zerberros/Audio_interfaces/README.md

# Audio_interfaces
Collection of audio interfaces

## CM6631 audio USB interface 

* USB2.0 true high-speed audio processor.

## CC85XX wireless interface

* (planned)
