zerberros/Audio_interfaces/USB_interface_board_CM6631/documentation/USB_Comunication-USB_Comunication.pdf

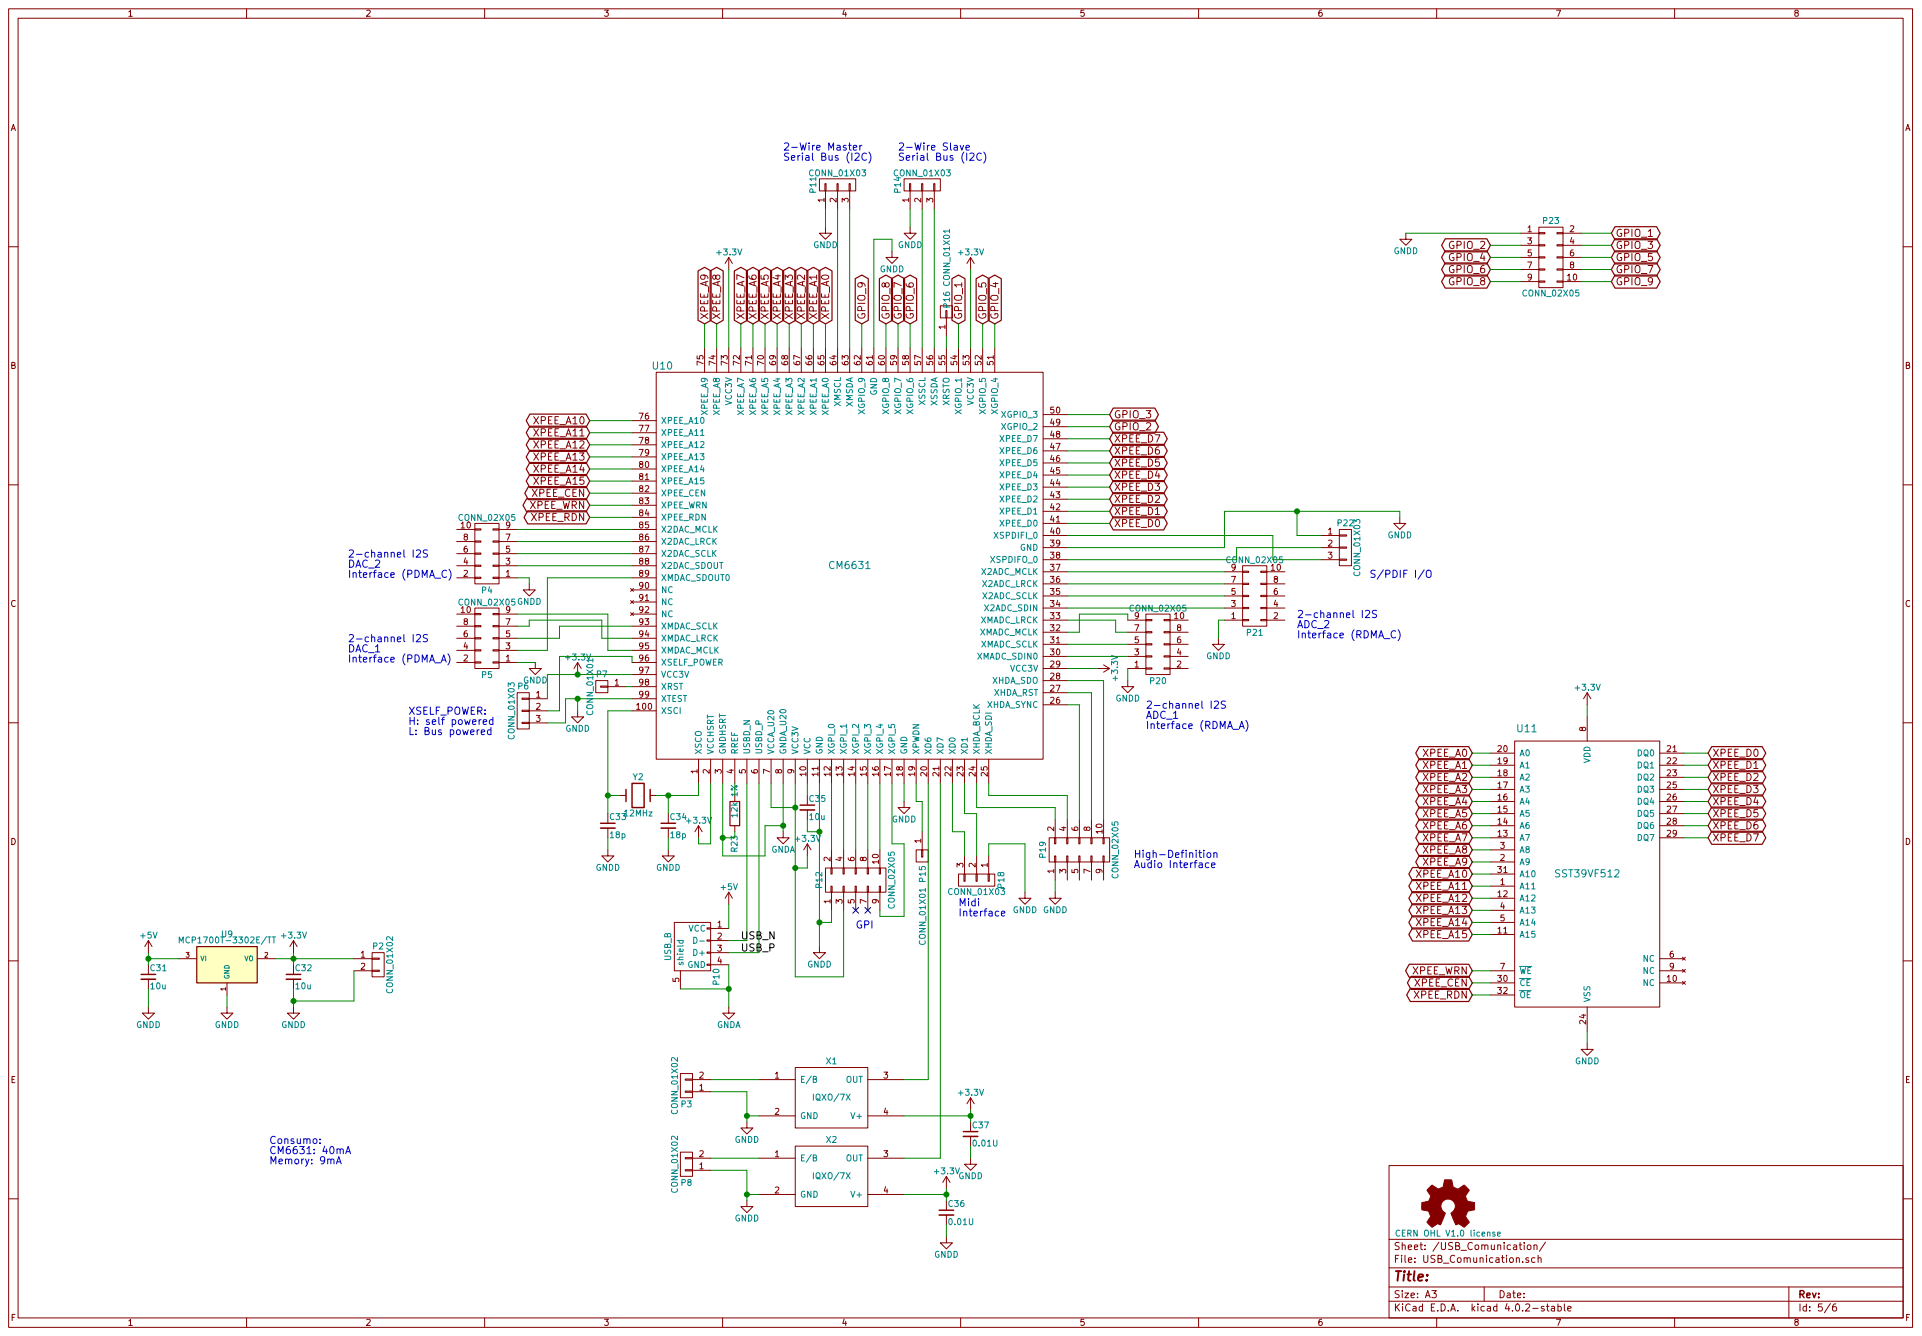
[picture p7: page 1]

1 P15 CONN_01X01 2-Wire Master Serial Bus (I2C)

9 VCC 10 XD6 20 XMADC_SDIN0 30 XSPDIFI_0 40 XGPIO_3 XGPIO_8 50 60 XPEE_A5 70 XPEE_A14 80 NC 90 GND 11 XD7 21 XMADC_SCLK 31 XPEE_D0 41 XGPIO_4 51 GND 61 XPEE_A6 71 XPEE_A15 81 NC 91 XGPI_0 12 XD0 22 XMADC_MCLK 32 XPEE_D1 42 XGPIO_5 52 XGPIO_9 62 XPEE_A7 72 XPEE_CEN 82 NC 92 XGPI_1 13 XD1 23 XMADC_LRCK 33 XPEE_D2 43 VCC3V 53 XMSDA 63 VCC3V 73 XPEE_WRN 83 XMDAC_SCLK 93 XGPI_2 14 XHDA_BCLK 24 X2ADC_SDIN 34 XPEE_D3 44 XGPIO_1 54 XMSCL 64 XPEE_A8 74 XPEE_RDN 84 XMDAC_LRCK 94 XGPI_3 15 XHDA_SDI 25 X2ADC_SCLK 35 XPEE_D4 45 XRSTO 55 XPEE_A0 65 XPEE_A9 75 X2DAC_MCLK 85 XMDAC_MCLK 95 XGPI_4 16 XHDA_SYNC 26 X2ADC_LRCK 36 XPEE_D5 46 XSSDA 56 XPEE_A1 66 XPEE_A10 76 X2DAC_LRCK 86 XSELF_POWER 96 XGPI_5 17 XHDA_RST 27 X2ADC_MCLK 37 XPEE_D6 47 XSSCL 57 XPEE_A2 67 XPEE_A11 77 X2DAC_SCLK 87 VCC3V 97 GND 18 XHDA_SDO 28 XSPDIFO_0 38 XPEE_D7 48 XGPIO_6 58 XPEE_A3 68 XPEE_A12 78 X2DAC_SDOUT 88 XRST 98 XPWDN 19 VCC3V 29 GND 39 XGPIO_2 49 XGPIO_7 59 XPEE_A4 69 XPEE_A13 79 XMDAC_SDOUT0 89 XTEST 99 XSCI 100 U10 CM6631

High-Definition Audio Interface GPI C34
