zerberros/Audio_interfaces/USB_interface_board_CM6631/USB_interface_board.kicad_pcb

## KiCad design USB_interface_board_CM6631/USB_interface_board.kicad_pcb (2021-04-11)

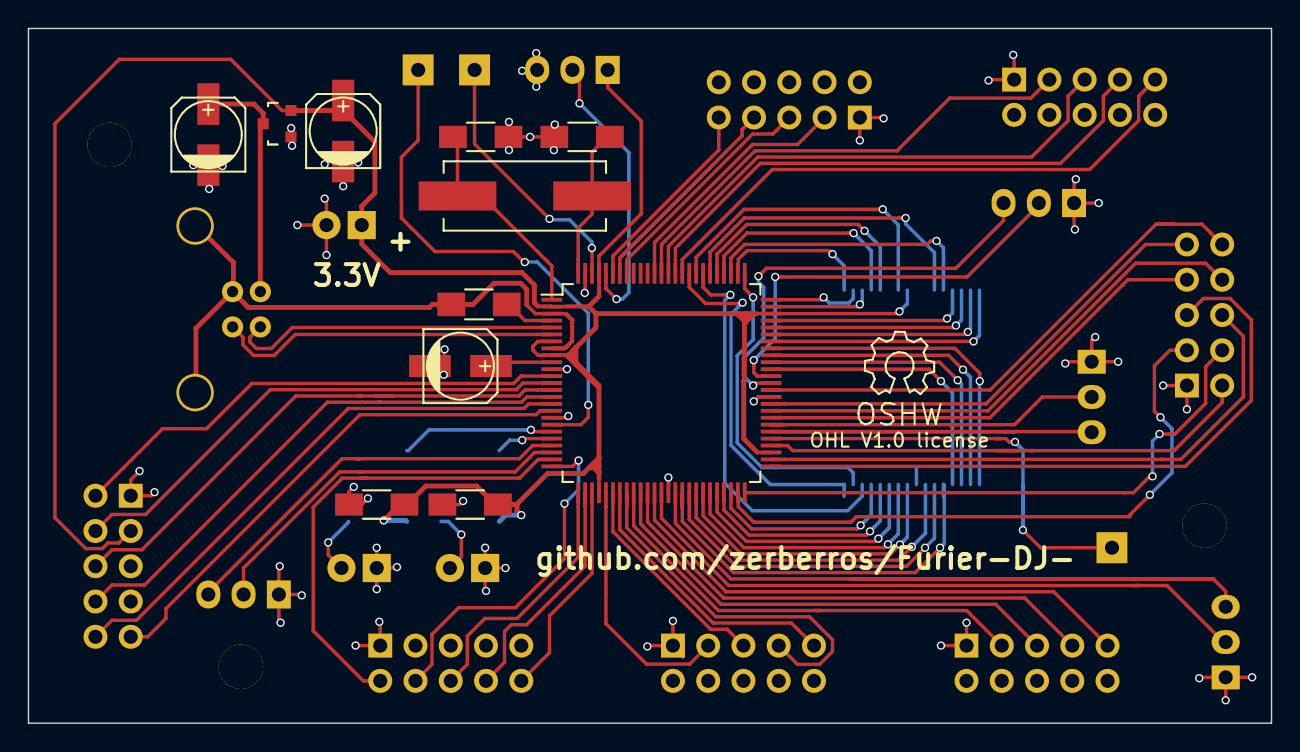
[picture p8: board USB_interface_board.kicad_pcb from above]

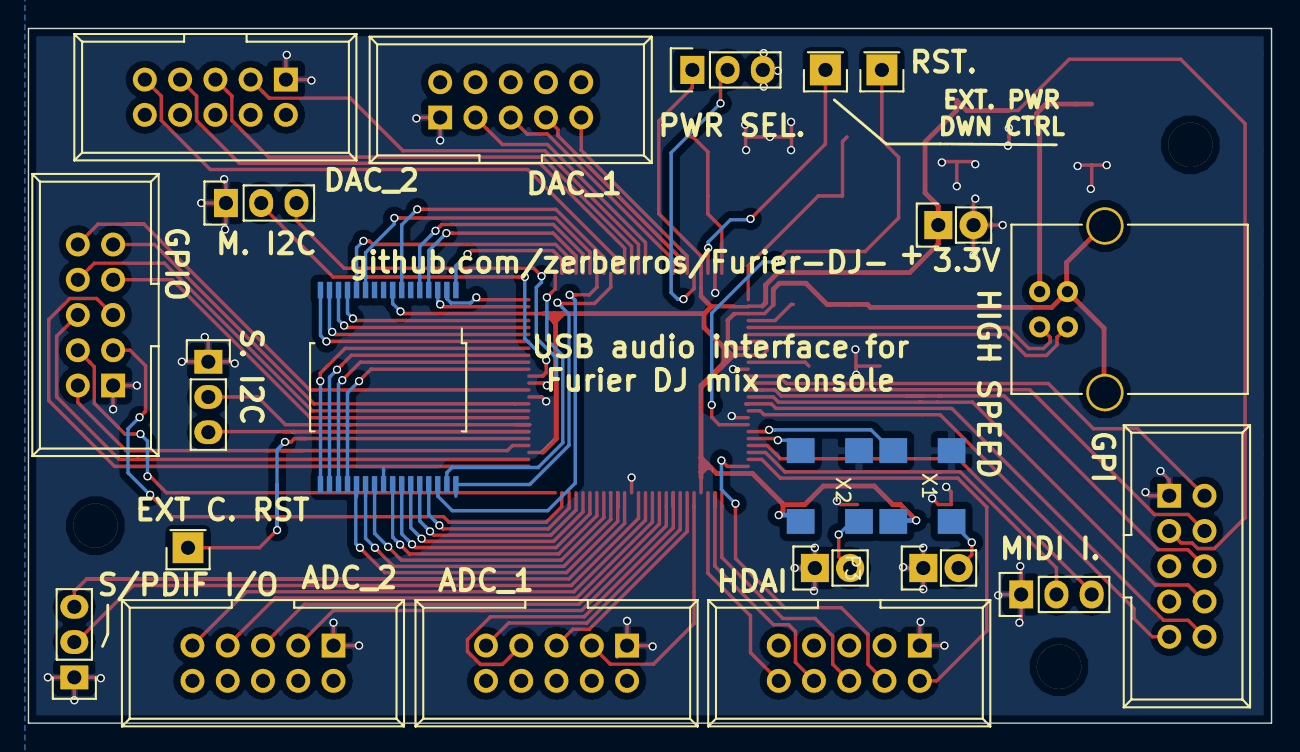
[picture p9: board USB_interface_board.kicad_pcb from below]

Board: 2 copper layers, 89.5 x 50.0 mm, 34 parts (22 on the bottom side), 89 nets.

Parts:
C31, C32, C35: 10u; c_elec_5x5.3
C33, C34: 18p; C_1206_HandSoldering
C36, C37: 0.01U; C_1206_HandSoldering
OHL V1.0 license: CERN OHL V1.0 license; Symbol_OSHW-Logo_SilkScreen
P2, P3, P8: CONN_01X02; Pin_Header_Straight_1x02
P4, P5, P12, P19, P20, P21, P23: CONN_02X05; IDC_Header_Straight_10pins
P6, P11, P14, P18, P22: CONN_01X03; Pin_Header_Straight_1x03
P7, P15, P16: CONN_01X01; Pin_Header_Straight_1x01
P10: USB_B
R23: 12k 1%; R_1206_HandSoldering
U9: MCP1700T-3302E/TT; SOT-23
U10: CM6631; LQFP-100_14x14mm_Pitch0.5mm
U11: SST39VF512; TSSOP-32_14x8mm_Pitch0.65mm
X1, X2: IQXO/7X; Oscillator
Y2: 12MHz; Crystal_HC49-SD_SMD

Connections:
+3V3: C32.1, C36.1, C37.1, P2.1, P6.1, P12.3, U9.2, U10.2, U10.7, U10.9, U10.29, U10.53, U10.73, U10.97, U11.8, X1.4, X2.4
+5V: C31.1, P10.1, U9.3
/Sheet5744DB9D/USB_N: P10.2, U10.5
/Sheet5744DB9D/USB_P: P10.3, U10.6
GNDA: P10.4, P10.5, R23.2, U10.3, U10.8
GNDD: C31.2, C32.2, C33.2, C34.2, C35.2, C36.2, C37.2, P2.2, P3.1, P4.1, P5.1, P6.3, P8.1, P11.1, P12.1, P14.1, P18.1, P19.1, P20.1, P21.1, P22.1, P23.1, U9.1, U10.11, U10.18, U10.39, U10.61, U10.99, U11.24, X1.2, X2.2
GPIO_1: P23.2, U10.54
GPIO_2: P23.3, U10.49
GPIO_3: P23.4, U10.50
GPIO_4: P23.5, U10.51
GPIO_5: P23.6, U10.52
GPIO_6: P23.7, U10.58
GPIO_7: P23.8, U10.59
GPIO_8: P23.9, U10.60
GPIO_9: P23.10, U10.62
unnamed: C33.1, U10.100, Y2.1
unnamed: C34.1, U10.1, Y2.2
unnamed: C35.1, U10.10
unnamed: P3.2, X1.1
unnamed: P4.3, U10.88
unnamed: P4.5, U10.87
unnamed: P4.7, U10.86
unnamed: P4.9, U10.85
unnamed: P5.3, U10.89
unnamed: P5.5, U10.93
unnamed: P5.7, U10.94
unnamed: P5.9, U10.95
unnamed: P6.2, U10.96
unnamed: P7.1, U10.98
unnamed: P8.2, X2.1
unnamed: P11.2, U10.64
unnamed: P11.3, U10.63
unnamed: P12.2, U10.12
unnamed: P12.4, U10.13
unnamed: P12.6, U10.14
unnamed: P12.8, U10.15
unnamed: P12.9, U10.17
unnamed: P12.10, U10.16
unnamed: P14.2, U10.57
unnamed: P14.3, U10.56
unnamed: P15.1, U10.19
unnamed: P16.1, U10.55
unnamed: P18.2, U10.23
unnamed: P18.3, U10.22
unnamed: P19.2, U10.24
unnamed: P19.4, U10.25
unnamed: P19.6, U10.26
unnamed: P19.8, U10.27
unnamed: P19.10, U10.28
unnamed: P20.3, U10.30
unnamed: P20.5, U10.31
unnamed: P20.7, U10.33
unnamed: P20.9, U10.32
unnamed: P21.3, U10.34
unnamed: P21.5, U10.35
unnamed: P21.7, U10.36
unnamed: P21.9, U10.37
unnamed: P22.2, U10.38
unnamed: P22.3, U10.40
unnamed: R23.1, U10.4
unnamed: U10.20, X1.3
unnamed: U10.21, X2.3
XPEE_A0: U10.65, U11.20
XPEE_A1: U10.66, U11.19
XPEE_A2: U10.67, U11.18
XPEE_A3: U10.68, U11.17
XPEE_A4: U10.69, U11.16
XPEE_A5: U10.70, U11.15
XPEE_A6: U10.71, U11.14
XPEE_A7: U10.72, U11.13
XPEE_A8: U10.74, U11.3
XPEE_A9: U10.75, U11.2
XPEE_A10: U10.76, U11.31
XPEE_A11: U10.77, U11.1
XPEE_A12: U10.78, U11.12
XPEE_A13: U10.79, U11.4
XPEE_A14: U10.80, U11.5
XPEE_A15: U10.81, U11.11
XPEE_CEN: U10.82, U11.30
XPEE_D0: U10.41, U11.21
XPEE_D1: U10.42, U11.22
XPEE_D2: U10.43, U11.23
XPEE_D3: U10.44, U11.25
XPEE_D4: U10.45, U11.26
XPEE_D5: U10.46, U11.27
XPEE_D6: U10.47, U11.28
XPEE_D7: U10.48, U11.29
XPEE_RDN: U10.84, U11.32
XPEE_WRN: U10.83, U11.7
